deepensolanki/Robotic-Hand/Hand.JPG

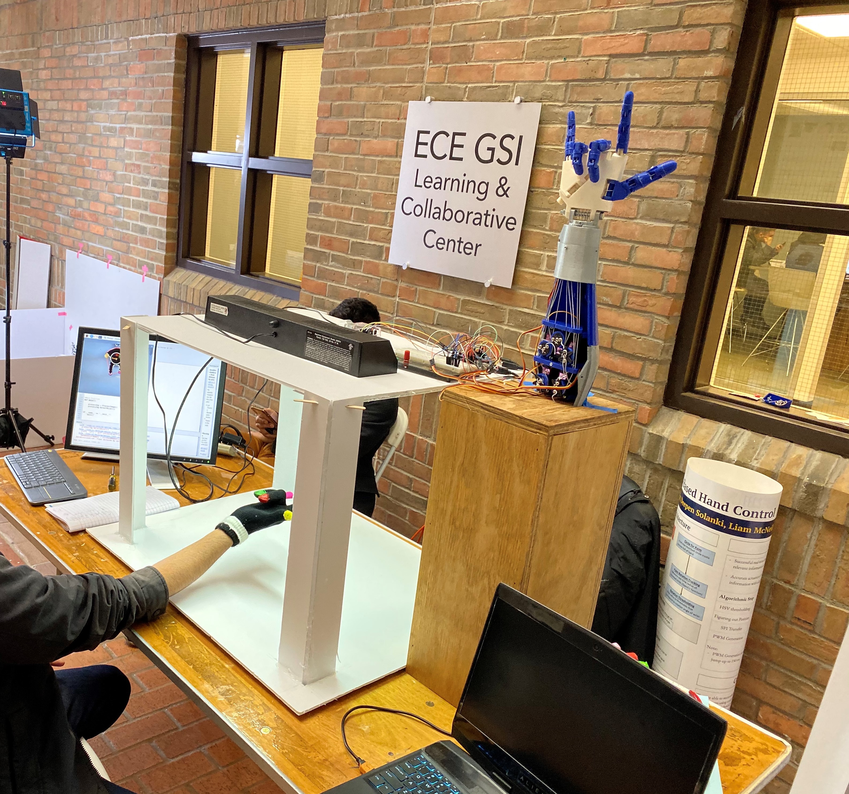
Hand.JPG
